ejangelico/lappd-hv-pcb/hv-pcb-v1/BOM/2-22-2024.xlsx

ID | # per board | spare per board | cost per part | number of boards | total required | total cost | component label | component type | value | vendor | product number | link | Note | Checked for correctness
 |  |  |  |  |  |  | todo
 |  |  |  |  |  |  | todo | SMD HV resistor, 2512 | 3M | Mouser | 660-HV733ATTE3004F | here (https://www.mouser.com/ProductDetail/KOA-Speer/HV733ATTE3004F?qs=DfG0HhEx1UX3Ky0h22TbUw%3D%3D) | For example, 2512 package type HV resistors
 |  |  |  |  |  |  | todo | SMD HV cap, 1812 | 100 pF | Mouser | C1812C101KHGACTU | here (https://www.mouser.com/ProductDetail/KEMET/C1812C101KHGACTU?qs=7%2FEGLSFhKGTKE0JrU3r0OQ%3D%3D)
 |  |  |  |  |  |  | todo | SMD HV cap, 1812 | 10 pF | Mouser | C1812C100KHGACTU | here (https://www.mouser.com/ProductDetail/KEMET/C1812C100KHGACTU?qs=fBk%252BzusEudgXuWEBx0Nzgw%3D%3D) |  | 2021-03-20
 |  |  |  |  |  |  | todo | SMD HV cap, 2220 | 1 nF | Mouser | C2220C102KHGACTU | here (https://www.mouser.com/ProductDetail/KEMET/C2220C102KHGACTU?qs=sDVxE4SYDkQiR6xwfhJl6Q%3D%3D)
 |  |  |  |  |  |  | todo | Through hole zener SOD-57 | 240V | Mouser | BZT03C240-TAP | here (https://www.mouser.com/ProductDetail/Vishay-Semiconductors/BZT03C240-TAP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) | High power through hole zeners, pick your favorite voltage
 |  |  |  |  |  |  | todo | SMD gnd cap, 1812 | 0.1 uF | Mouser | C1812C104K2RACAUTO | here (https://www.mouser.com/ProductDetail/KEMET/C1812C104K2RACAUTO?qs=MyNHzdoqoQIr15pDtur0ag%3D%3D) | coupling to ACDC ground
 |  |  |  |  |  |  |  | 2W 10K ohm HV resistor for protection | 10k | Mouser | SM204031002JE | here (https://www.mouser.com/ProductDetail/Ohmite/SM204031002JE?qs=SR60igVWod0S51Lvl28NcQ%3D%3D)
 |  |  |  |  |  |  |  | 2W 1M HV resistor for protection | 1M | Mouser | SM204031004JE | here (https://www.mouser.com/ProductDetail/Ohmite/SM204031004JE?qs=SR60igVWod1HVgyIZMvH%2Fg%3D%3D)
 |  |  |  |  |  | Overall total
 |  |  |  |  |  | 0
