ejangelico/lappd-hv-pcb/hv-pcb-v1/BOM/5-13-24.xlsx

ID | # per board | spare per board | cost per part | number of boards | total required | total cost | component label | component type | value | vendor | product number | link | Note | Checked for correctness
 | 1 | 1 | 0.75 | 2 | 4 | 3 | R3 | SMD HV resistor, 2512 | 100k | Mouser | HV733ATTE104J | here (https://www.mouser.com/ProductDetail/KOA-Speer/HV733ATTE104J?qs=DfG0HhEx1UU705sPg0eXoQ%3D%3D) |  | 2024-05-07
 | 8 | 1 | 0.85 | 2 | 18 | 15.3 | R1 - R17 but not R3 | 1M, 1W, 3kV, 1% 2512 | 1M | Mouser | HV733ATTE1004F | here (https://www.mouser.com/ProductDetail/KOA-Speer/HV733ATTE1004F?qs=DfG0HhEx1UUt9h15f61fPQ%3D%3D) |  | 2024-05-07
 | 2 | 1 | 1.13 | 2 | 6 | 6.78 | R1 - R17 but not R3 | 3M, 1W, 3kV, 1% SMD HV resistor, 2512 | 3M | Mouser | 660-HV733ATTE3004F | here (https://www.mouser.com/ProductDetail/KOA-Speer/HV733ATTE3004F?qs=DfG0HhEx1UX3Ky0h22TbUw%3D%3D) |  | 2024-05-07
 | 2 | 1 | 1.53 | 2 | 6 | 9.18 | C1, C4 | SMD HV cap, 1812 | 100 pF | Mouser | C1812C101KHGACTU | here (https://www.mouser.com/ProductDetail/KEMET/C1812C101KHGACTU?qs=7%2FEGLSFhKGTKE0JrU3r0OQ%3D%3D) |  | 2024-05-07
 | 6 | 1 | 1.8 | 2 | 14 | 25.2 | C3, C6, C8, C10, C12, C11 | SMD HV cap, 1812 | 10 pF | Mouser | C1812C100JHGACTU | here (https://www.mouser.com/ProductDetail/KEMET/C1812C100JHGACTU?qs=tvSVM0koh%2FO1gTMjuQGCFw%3D%3D) |  | 2024-05-07
 | 4 | 1 | 2.9 | 2 | 10 | 29 | C2, C5, C7, C9 | SMD HV cap, 2220 | 1 nF | Mouser | C2220C102KHGACTU | here (https://www.mouser.com/ProductDetail/KEMET/C2220C102KHGACTU?qs=sDVxE4SYDkQiR6xwfhJl6Q%3D%3D) |  | 2024-05-07
 | 2 | 1 | 0.61 | 2 | 6 | 3.66 | D2, D3 | SOD-57 200V zeners for gaps | 200V | Mouser | BZT03C200-TAP | here (https://www.mouser.com/ProductDetail/Vishay-Semiconductors/BZT03C200-TR?qs=yIvl1B2wDi7A4uZkUOXxvg%3D%3D) |  | 2024-05-13
 | 11 | 2 | 0.61 | 2 | 26 | 15.86 | D1, D4, D5, D6, D7, D8, D9, D10, D11 | 240V zener SOD-57 | 240V | Mouser | BZT03C240-TAP | here (https://www.mouser.com/ProductDetail/Vishay-Semiconductors/BZT03C240-TAP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) |  | 2024-05-13
 | 2 | 1 | 0.74 | 2 | 6 | 4.44 | C12, C11 | SMD gnd cap, 1812 | 0.1 uF | Mouser | C1812C104K2RACAUTO | here (https://www.mouser.com/ProductDetail/KEMET/C1812C104K2RACAUTO?qs=MyNHzdoqoQIr15pDtur0ag%3D%3D) | An optional different higher capacitance coupling to ACDC ground | 2024-05-07
 | 2 | 1 | 5.97 | 2 | 6 | 35.82 | R19, R22 | 2W 10K ohm HV resistor for protection | 10k | Mouser | SM204031002JE | here (https://www.mouser.com/ProductDetail/Ohmite/SM204031002JE?qs=SR60igVWod0S51Lvl28NcQ%3D%3D) |  | 2024-05-07
 | 2 | 1 | 7.37 | 2 | 6 | 44.22 | R24, R23 | 2W 1M HV resistor for protection | 1M | Mouser | SM204031004JE | here (https://www.mouser.com/ProductDetail/Ohmite/SM204031004JE?qs=SR60igVWod1HVgyIZMvH%2Fg%3D%3D) |  | 2024-05-07
 |  |  |  |  |  | Overall total
 |  |  |  |  |  | 192.46
