ejangelico/lappd-hv-pcb/hv-pcb-v1/output-files/hv-pcb-v1.step

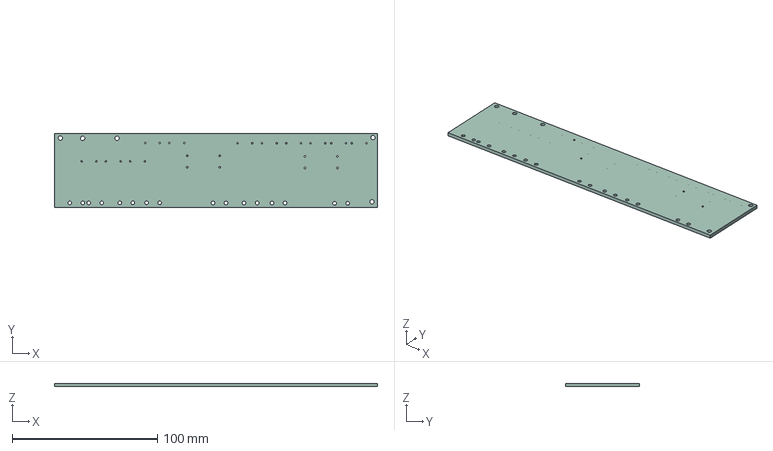
[picture p1: CAD file, 2024-05-28]
hv-pcb-v1/output-files/hv-pcb-v1.step
222.6 x 50.8 x 2.38 mm
