ejangelico/lappd-hv-pcb/hv-pcb-v1/output-files/schematics/hv-pcb-v1-3-22-24.pdf

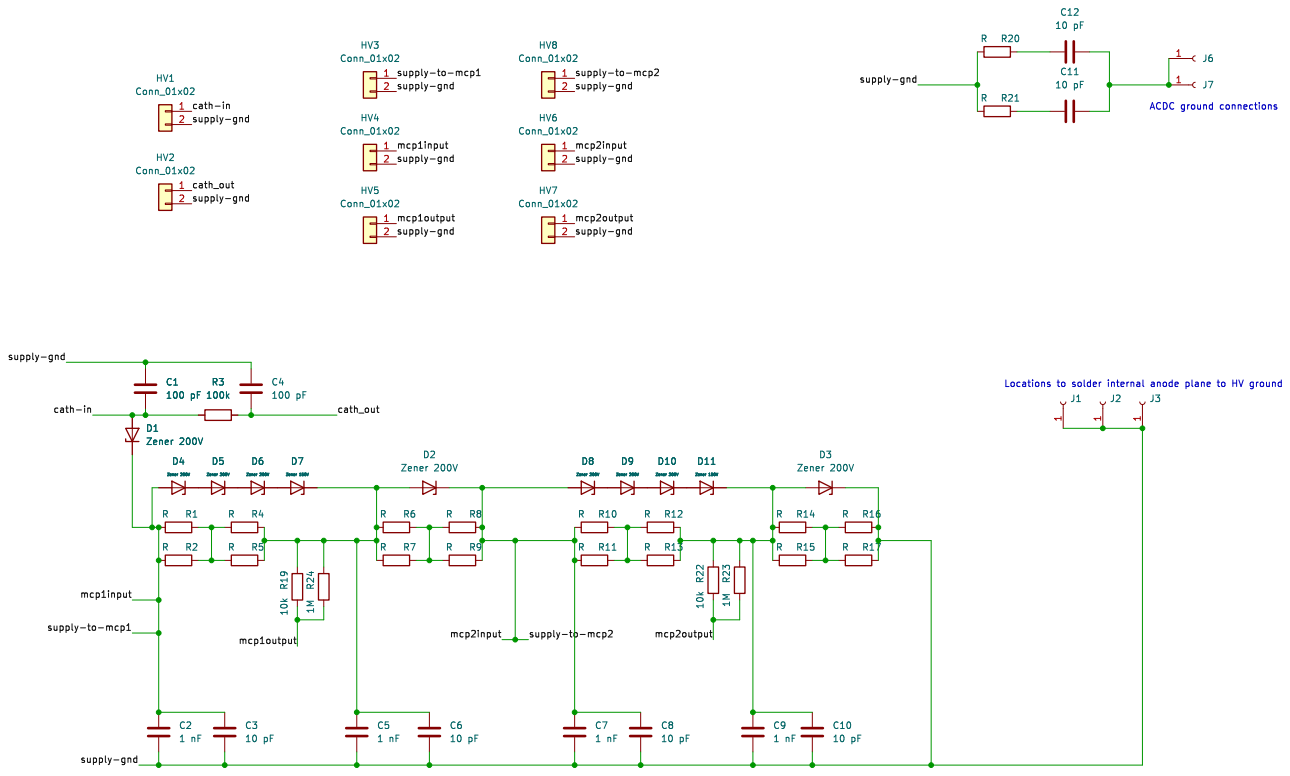
[picture p2: page 1]
