ejangelico/lappd-hv-pcb/hv-pcb-v1/output-files/schematics/hv-pcb-v1-5-6-24.pdf

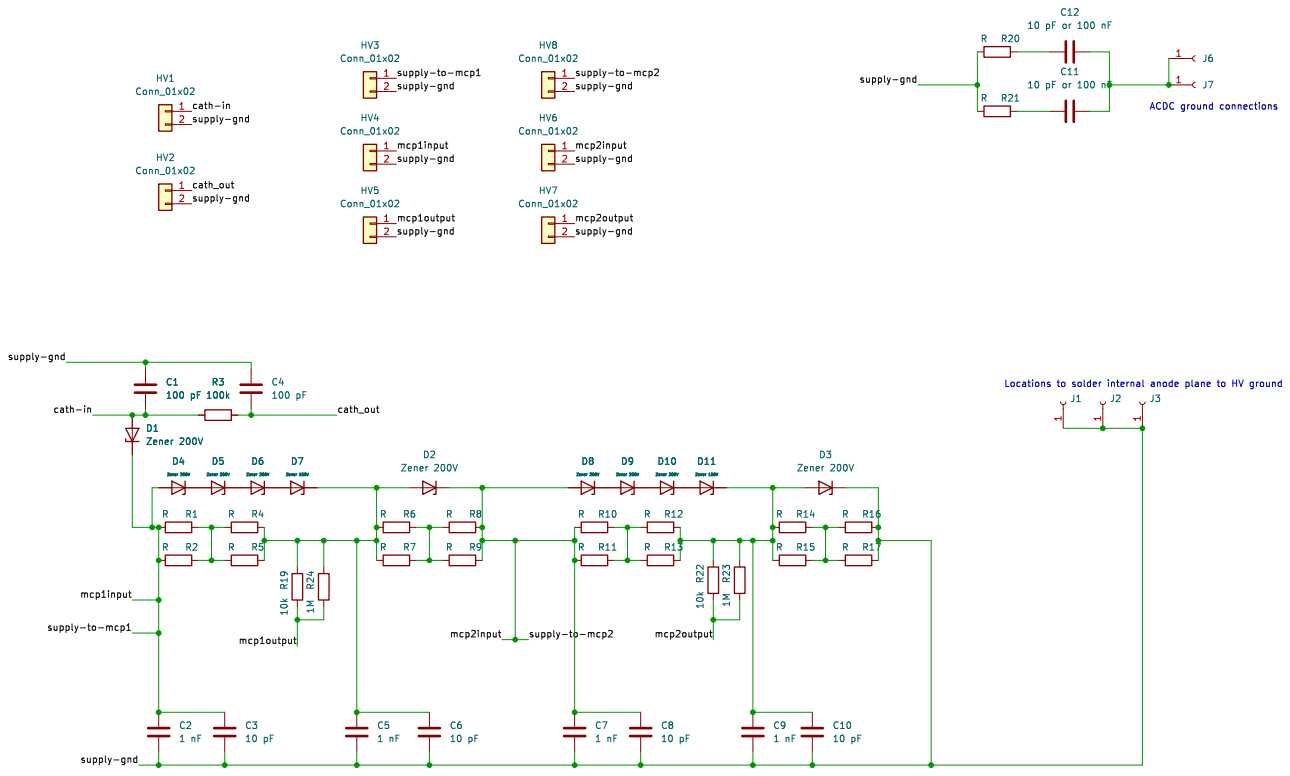
[picture p3: page 1]
