ejangelico/lappd-hv-pcb/spice/86-divider-open.asc

D1: zener; BZT03C240
D2: zener; BZT03C200
D3: zener; BZT03C240
D4: zener; BZT03C200
D5: zener; BZT03C200
D6: zener; BZT03C240
D7: zener; BZT03C240
D8: zener; BZT03C240
D9: zener; BZT03C240
D10: zener; BZT03C240
D11: zener; BZT03C240
MCP1: res; 9.2e6
MCP2: res; 8.5e6
R1: res; 10e3
R3: res; 10e3
R4: res; 2e6
R6: res; 2e6
R7: res; 1e6
R9: res; 100e3
R11: res; 1e6
V1: voltage; 1100
V2: voltage; 2200
V3: voltage; 2200
Named nets: supply-gnd, mcp1input, mcp1output, mcp2inpt, mcp2output, 0, mcp1supply, mcp2supply, cathode
.op
********************************
* Copyright:                   *
* Vishay Intertechnology, Inc. *
********************************
* Technology: DISCRETE Zener DIODE
* Device: Diode 
* Description:
* Type: Typical (nom)
* Model established: 09.2008, by Harald Stix, VSA/ASSP-VOE
* Wafer:
* Remarks:
* Revision: 09.2008
* Simulation Model: 
* Simulator: PSPICE
*DEVICE=BZT03C240,D
* BZT03C200 D model
* created using Parts release 8.0 on 08/2008
* Parts is a MicroSim product.
.MODEL BZT03C240 D
+ IS=1.0661E-12
+ N=1.4483
+ RS=.11915
+ IKF=13.524E-3
+ CJO=99.962E-12
+ M=.29316
+ VJ=.42846
+ ISR=3.8425E-9
+ NR=1.9996
+ BV=240
+ IBV=10.348E-3
+ TT=4.5627E-6
*$
200V zeners have 200 ohm dynamic resistance at 5 mA
********************************
* Copyright:                   *
* Vishay Intertechnology, Inc. *
********************************
* Technology: DISCRETE Zener DIODE
* Device: Diode 
* Description:
* Type: Typical (nom)
* Model established: 09.2008, by Harald Stix, VSA/ASSP-VOE
* Wafer:
* Remarks:
* Revision: 09.2008
* Simulation Model: 
* Simulator: PSPICE
*DEVICE=BZT03C200,D
* BZT03C200 D model
* created using Parts release 8.0 on 08/2008
* Parts is a MicroSim product.
.MODEL BZT03C200 D
+ IS=1.0661E-12
+ N=1.4483
+ RS=.11915
+ IKF=13.524E-3
+ CJO=99.962E-12
+ M=.29316
+ VJ=.42846
+ ISR=3.8425E-9
+ NR=1.9996
+ BV=200
+ IBV=10.348E-3
+ TT=4.5627E-6
*$
LAPPD 86 has max MCP voltage of 950V 
Gain = 1.75e6 at 850V
Gain = 3.5e6 at 900V
Gain = 6e6 at 925V
(all at 10V PC, at 50V it increases maybe by 50%)
