ejangelico/lappd-hv-pcb/hv-pcb-v1/hv-pcb-v1.kicad_pcb

## KiCad design hv-pcb-v1/hv-pcb-v1.kicad_pcb (2024-05-28)

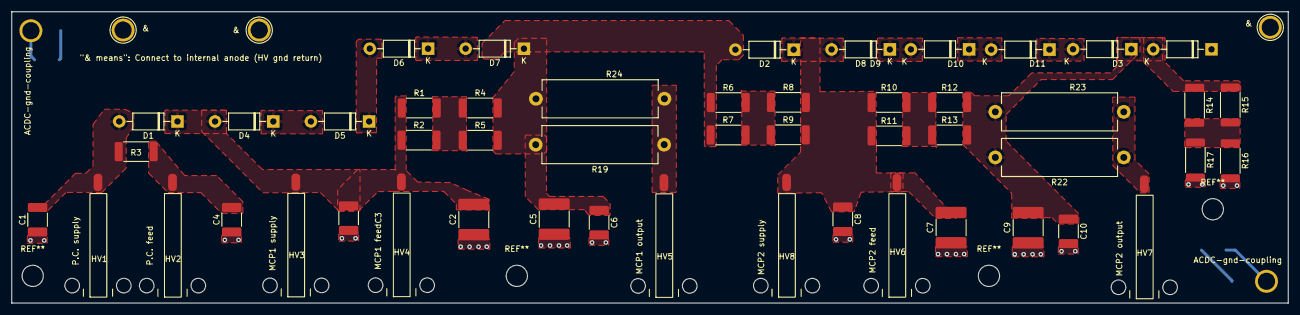
[picture p4: board hv-pcb-v1.kicad_pcb from above]

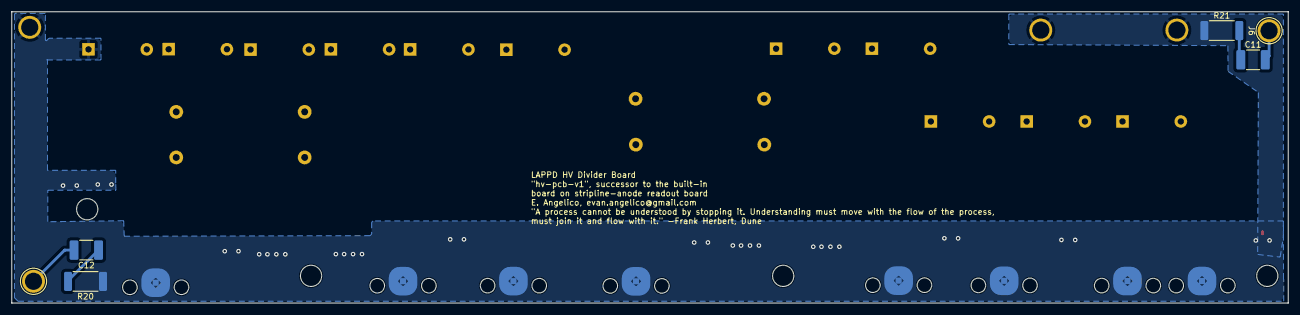
[picture p5: board hv-pcb-v1.kicad_pcb from below]

Board: 2 copper layers, 222.6 x 50.8 mm, 59 parts (6 on the bottom side), 22 nets.

Parts:
C1, C4: 100 pF; C_1812_4532Metric_Pad1.57x3.40mm_HandSolder
C2, C5, C7, C9: 1 nF; C_2220_5650Metric_Pad1.97x5.40mm_HandSolder
C3, C6, C8, C10, C11, C12: 10 pF; C_1812_4532Metric_Pad1.57x3.40mm_HandSolder
D1, D2, D3, D4, D5, D6, D8, D9, D10: Zener 200V; D_DO-41_SOD81_P10.16mm_Horizontal
D7, D11: Zener 150V; D_DO-41_SOD81_P10.16mm_Horizontal
HV1, HV2, HV3, HV4, HV5, HV6, HV7, HV8: Conn_01x02; SHV_cable_interface
J1, J2, J3, J6, J7: Conn_01x01_Socket; TestPoint_Plated_Hole_D3.0mm
R1, R2, R4, R5, R6, R7, R8, R9, R10, R11, R12, R13, R14, R15, R16, R17, R20, R21: R; R_2512_6332Metric_Pad1.40x3.35mm_HandSolder
R3: 100k; R_2512_6332Metric_Pad1.40x3.35mm_HandSolder
R19, R22: 10k; R_Axial_Power_L20.0mm_W6.4mm_P22.40mm
R23, R24: 1M; R_Axial_Power_L20.0mm_W6.4mm_P22.40mm

Connections:
/cath-in: C1.2, D1.2 (A), HV1.1, R3.1
/cath_out: C4.2, HV2.1, R3.2
/mcp1input: C2.2, C3.1, D1.1 (K), D4.2 (A), HV3.1, HV4.1, R1.1, R2.1
/mcp1output: HV5.1, R19.1, R24.1
/mcp2input: C7.2, C8.1, D2.1 (K), D8.2 (A), HV6.1, HV8.1, R8.2, R9.2, R10.1, R11.1
/mcp2output: HV7.1, R22.1, R23.1
/supply-gnd: C1.1, C2.1, C3.2, C4.1, C5.1, C6.2, C7.1, C8.2, C9.1, C10.2, D3.1 (K), HV1.2, HV2.2, HV3.2, HV4.2, HV5.2, HV6.2, HV7.2, HV8.2, J1.1, J2.1, J3.1, R16.2, R17.2, R20.1, R21.1
unnamed: C11.1, R21.2
unnamed: C12.1, R20.2
unnamed: C5.2, C6.1, D2.2 (A), D7.1 (K), R4.2, R5.2, R6.1, R7.1, R19.2, R24.2
unnamed: D4.1 (K), D5.2 (A)
unnamed: D5.1 (K), D6.2 (A)
unnamed: D6.1 (K), D7.2 (A)
unnamed: D8.1 (K), D9.2 (A)
unnamed: D9.1 (K), D10.2 (A)
unnamed: D10.1 (K), D11.2 (A)
unnamed: C9.2, C10.1, D3.2 (A), D11.1 (K), R12.2, R13.2, R14.1, R15.1, R22.2, R23.2
unnamed: C11.2, C12.2, J6.1, J7.1
unnamed: R1.2, R2.2, R4.1, R5.1
unnamed: R6.2, R7.2, R8.1, R9.1
unnamed: R10.2, R11.2, R12.1, R13.1
unnamed: R14.2, R15.2, R16.1, R17.1
